makeriga/weatherthing-hardware/README.md

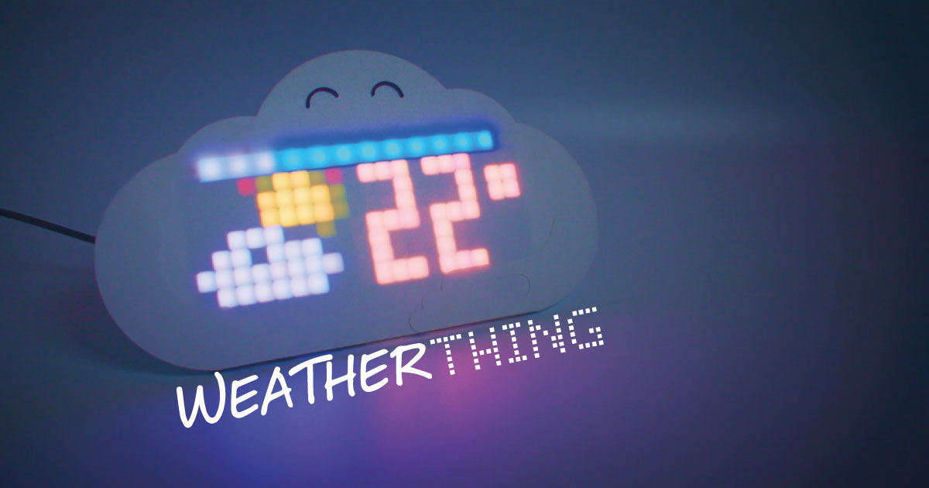
[picture p1: img/weatherthing.jpg]
Weatherthing photo

# weatherthing-hardware
hardware for WeatherThing LED matrix
R0 PCB source files and mech parts + manual pdf
Note: R0 pcb somehow no one paid attention to the 1117 LDO Vin low voltage, thus the battery charging, protection and power path section kinda became redundant. Pls omit or DNP those parts.
