makeriga/weatherthing-hardware/img/box.jpg

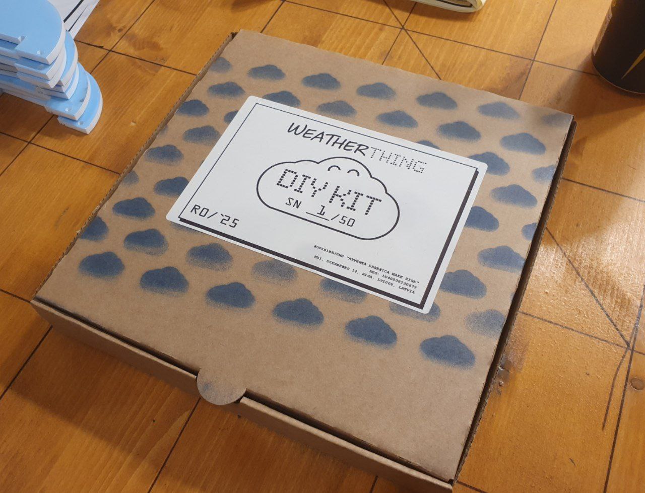
img/box.jpg
