makeriga/weatherthing-hardware/img/contents.jpg

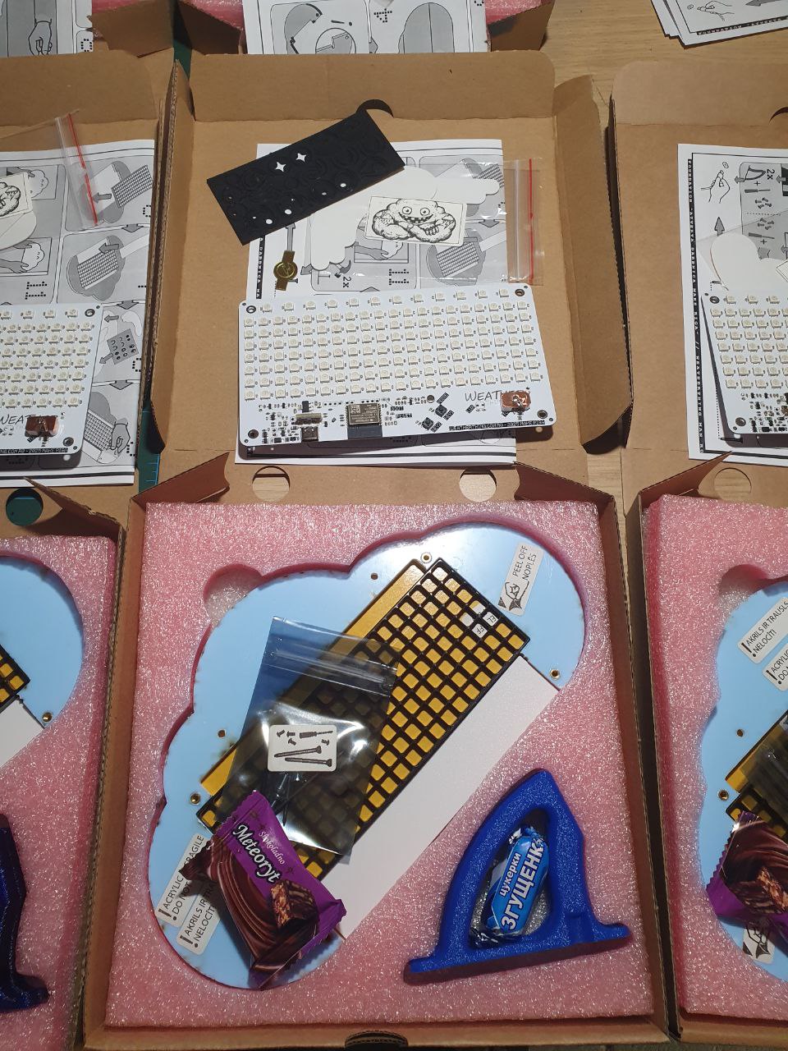
img/contents.jpg
