makeriga/weatherthing-hardware/img/customer1.jpg

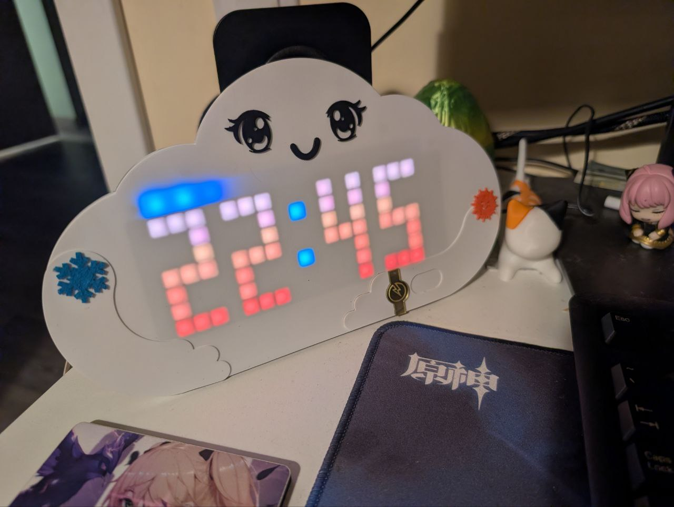
img/customer1.jpg
