makeriga/weatherthing-hardware/img/customer2.jpg

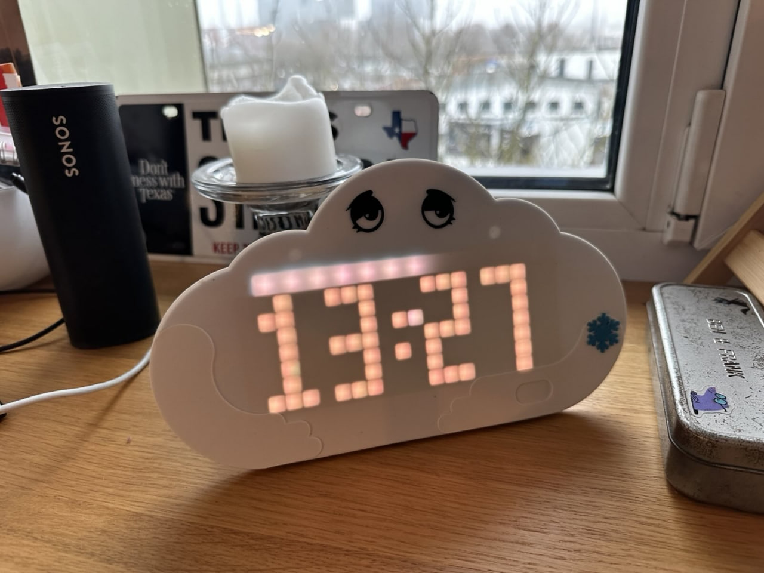
img/customer2.jpg
