makeriga/weatherthing-hardware/img/pcb.jpg

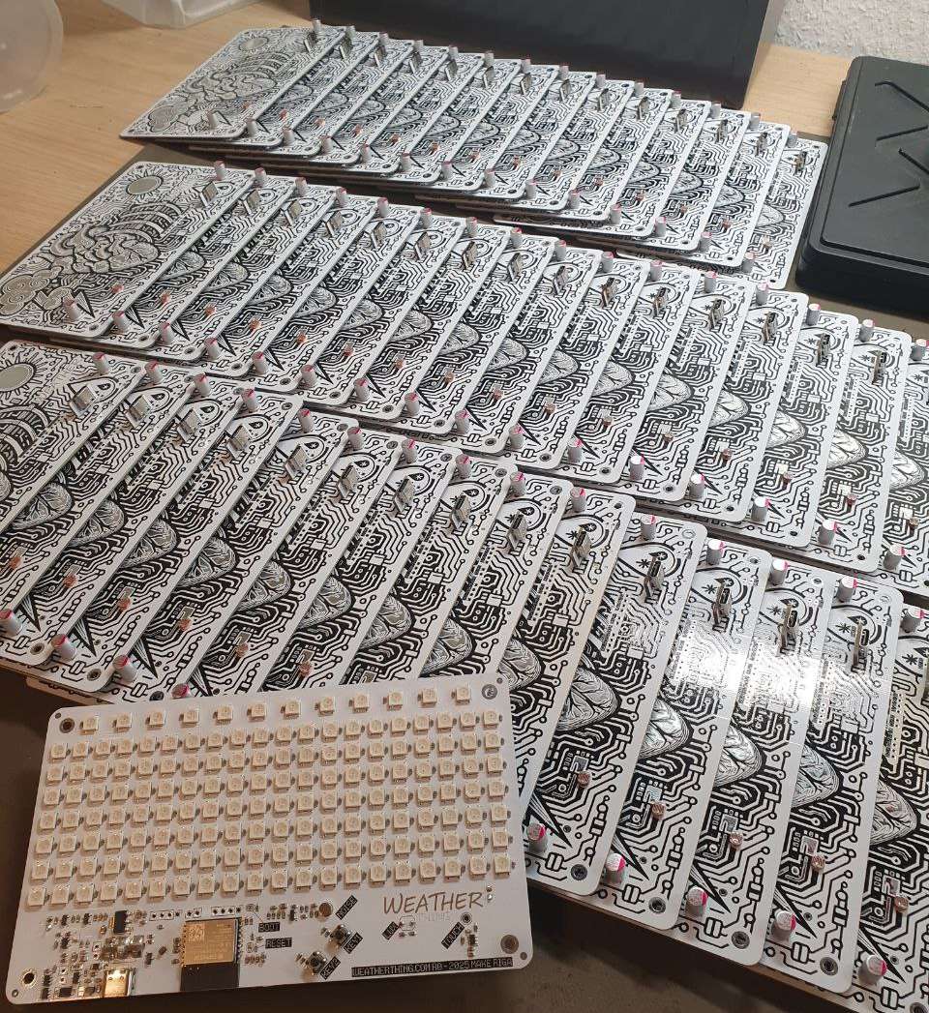
img/pcb.jpg
