makeriga/weatherthing-hardware/mech/support-leg.STEP

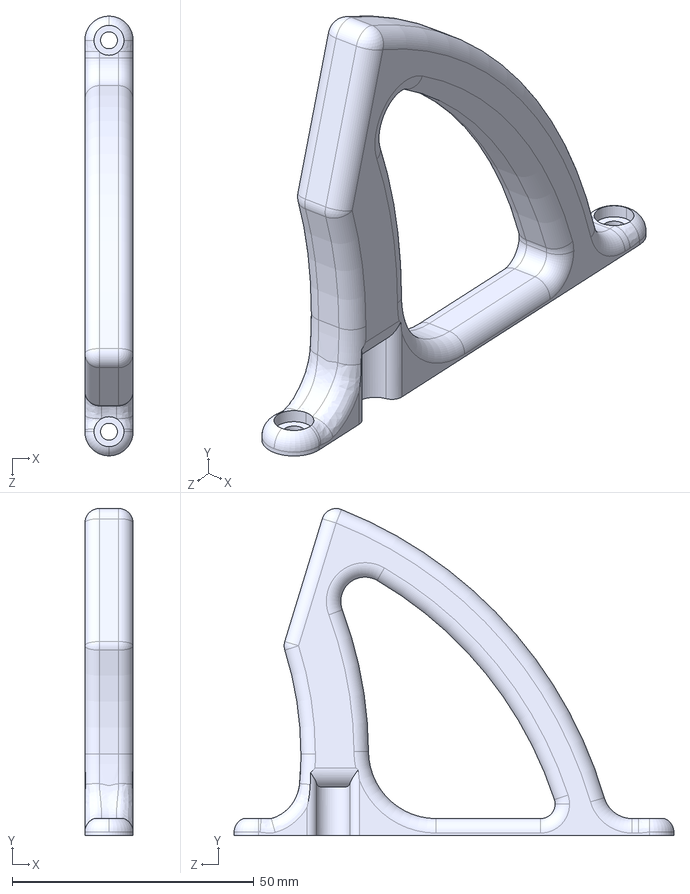
[picture p7: CAD file, 2025-12-18]
mech/support-leg.STEP
10.0 x 67.7 x 91.0 mm
