makeriga/weatherthing-hardware/mech/front-diffuser-0.5mm-PP-doublesided-bottom.DXF

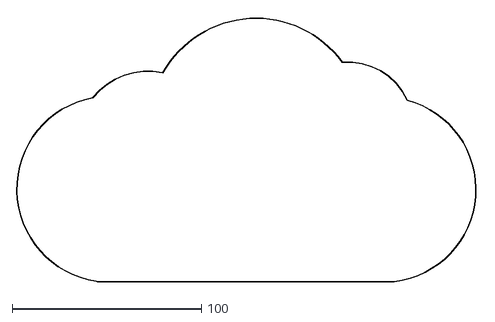
[picture p8: CAD file, 2025-12-18]
mech/front-diffuser-0.5mm-PP-doublesided-bottom.DXF
244.7 x 140.3
