makeriga/weatherthing-hardware/mech/spacer-white-5mm-acrylic.DXF

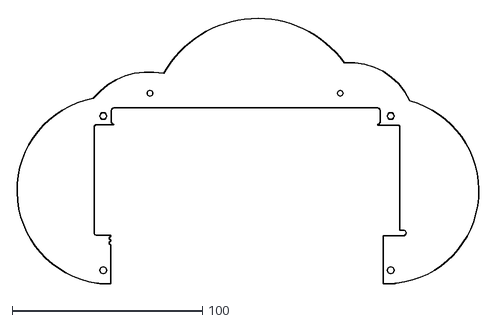
[picture p9: CAD file, 2025-12-18]
mech/spacer-white-5mm-acrylic.DXF
244.7 x 140.3
