makeriga/weatherthing-hardware/mech/crossbleed-stopping-spacer-black-5mm-acrylic.DXF

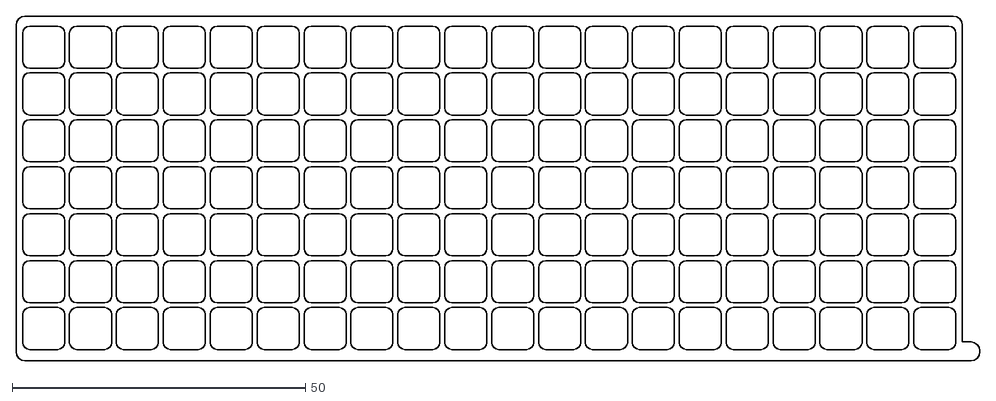
[picture p10: CAD file, 2025-12-18]
mech/crossbleed-stopping-spacer-black-5mm-acrylic.DXF
164.4 x 58.7
