makeriga/weatherthing-hardware/mech/Pizzabox-holder-20mm-PE-ESD-foam.dxf

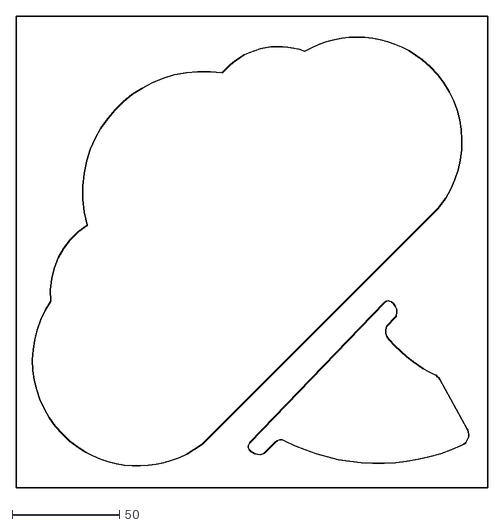
[picture p11: CAD file, 2025-12-18]
mech/Pizzabox-holder-20mm-PE-ESD-foam.dxf
220.0 x 220.0
