makeriga/weatherthing-hardware/mech/front-diffuser-backing-plate-0.5mm-PP-no-adhesive.DXF

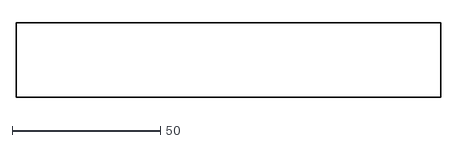
[picture p12: CAD file, 2025-12-18]
mech/front-diffuser-backing-plate-0.5mm-PP-no-adhesive.DXF
143.0 x 25.1
