makeriga/weatherthing-hardware/mech/touch-thingy-5mm.DXF

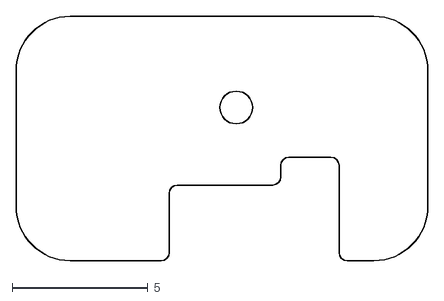
[picture p13: CAD file, 2025-12-18]
mech/touch-thingy-5mm.DXF
15.2 x 9.00
