makeriga/weatherthing-hardware/mech/eyes.dxf

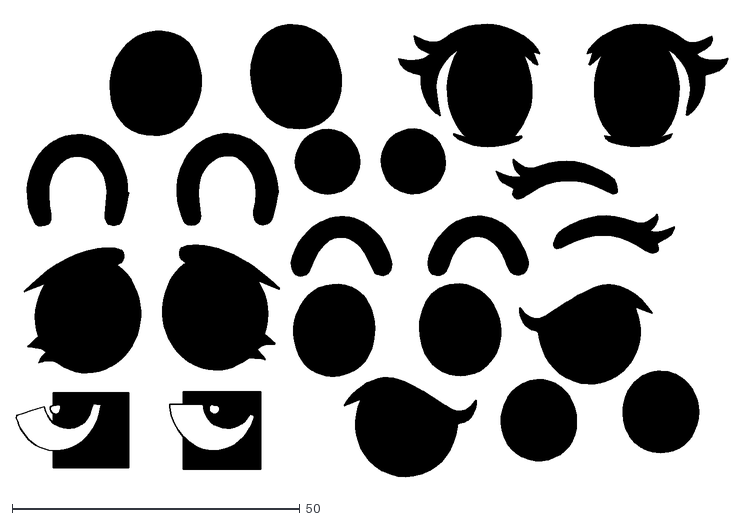
[picture p14: CAD file, 2025-12-18]
mech/eyes.dxf
123.7 x 81.0
