makeriga/weatherthing-hardware/mech/arms-0.5mm-PP-doublesided-bottom.DXF

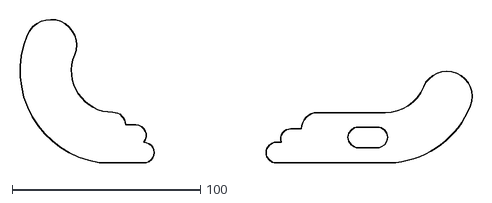
[picture p15: CAD file, 2025-12-18]
mech/arms-0.5mm-PP-doublesided-bottom.DXF
243.9 x 78.0
