makeriga/weatherthing-hardware/(list of files, cad)

Other CAD files:
PCB/R0/weatherthing-usb-pcb/weatherthing-usb-pcb-F_Paste.dxf
