makeriga/weatherthing-hardware/img/assembly.jpg

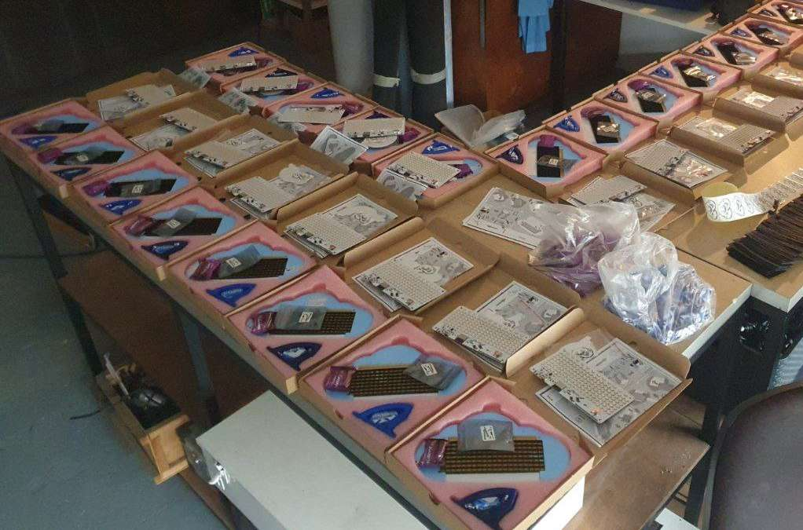
img/assembly.jpg
