makeriga/weatherthing-hardware/img/manual1.jpg

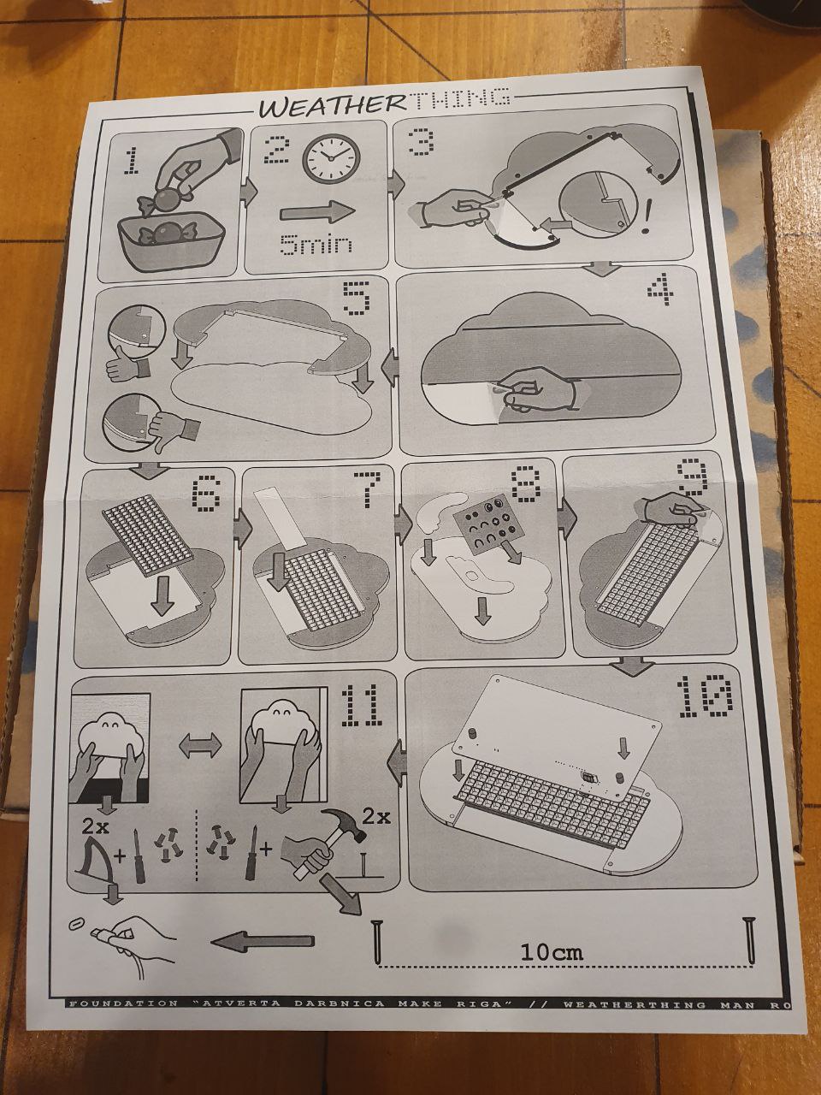
img/manual1.jpg
