makeriga/weatherthing-hardware/img/manual2.jpg

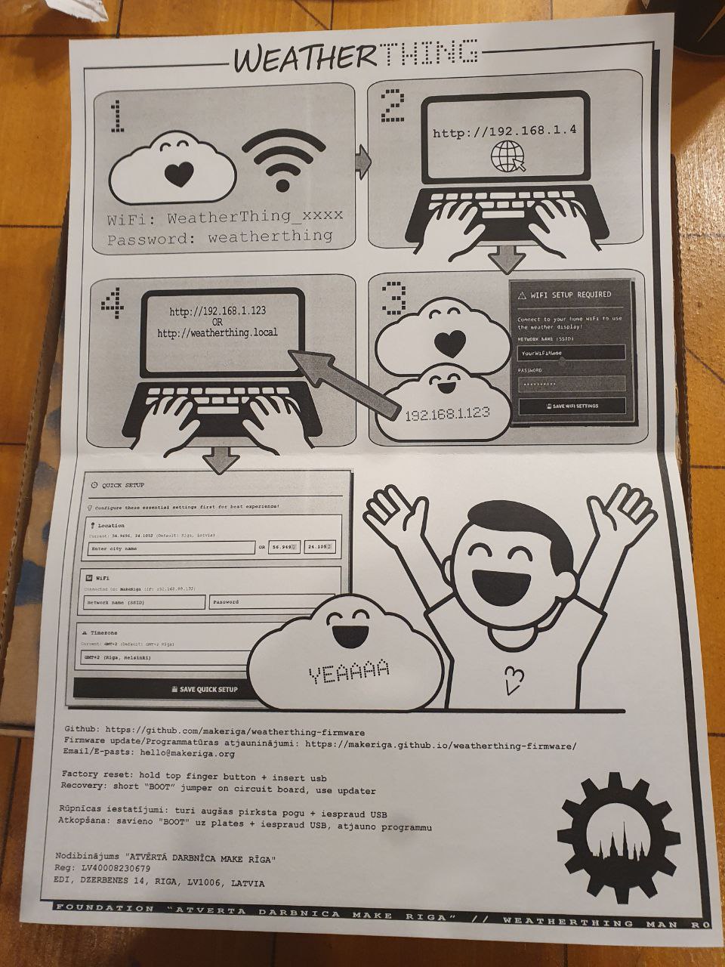
img/manual2.jpg
