makeriga/weatherthing-hardware/PCB/R0/Weatherthing-main-21-30-R0.pdf

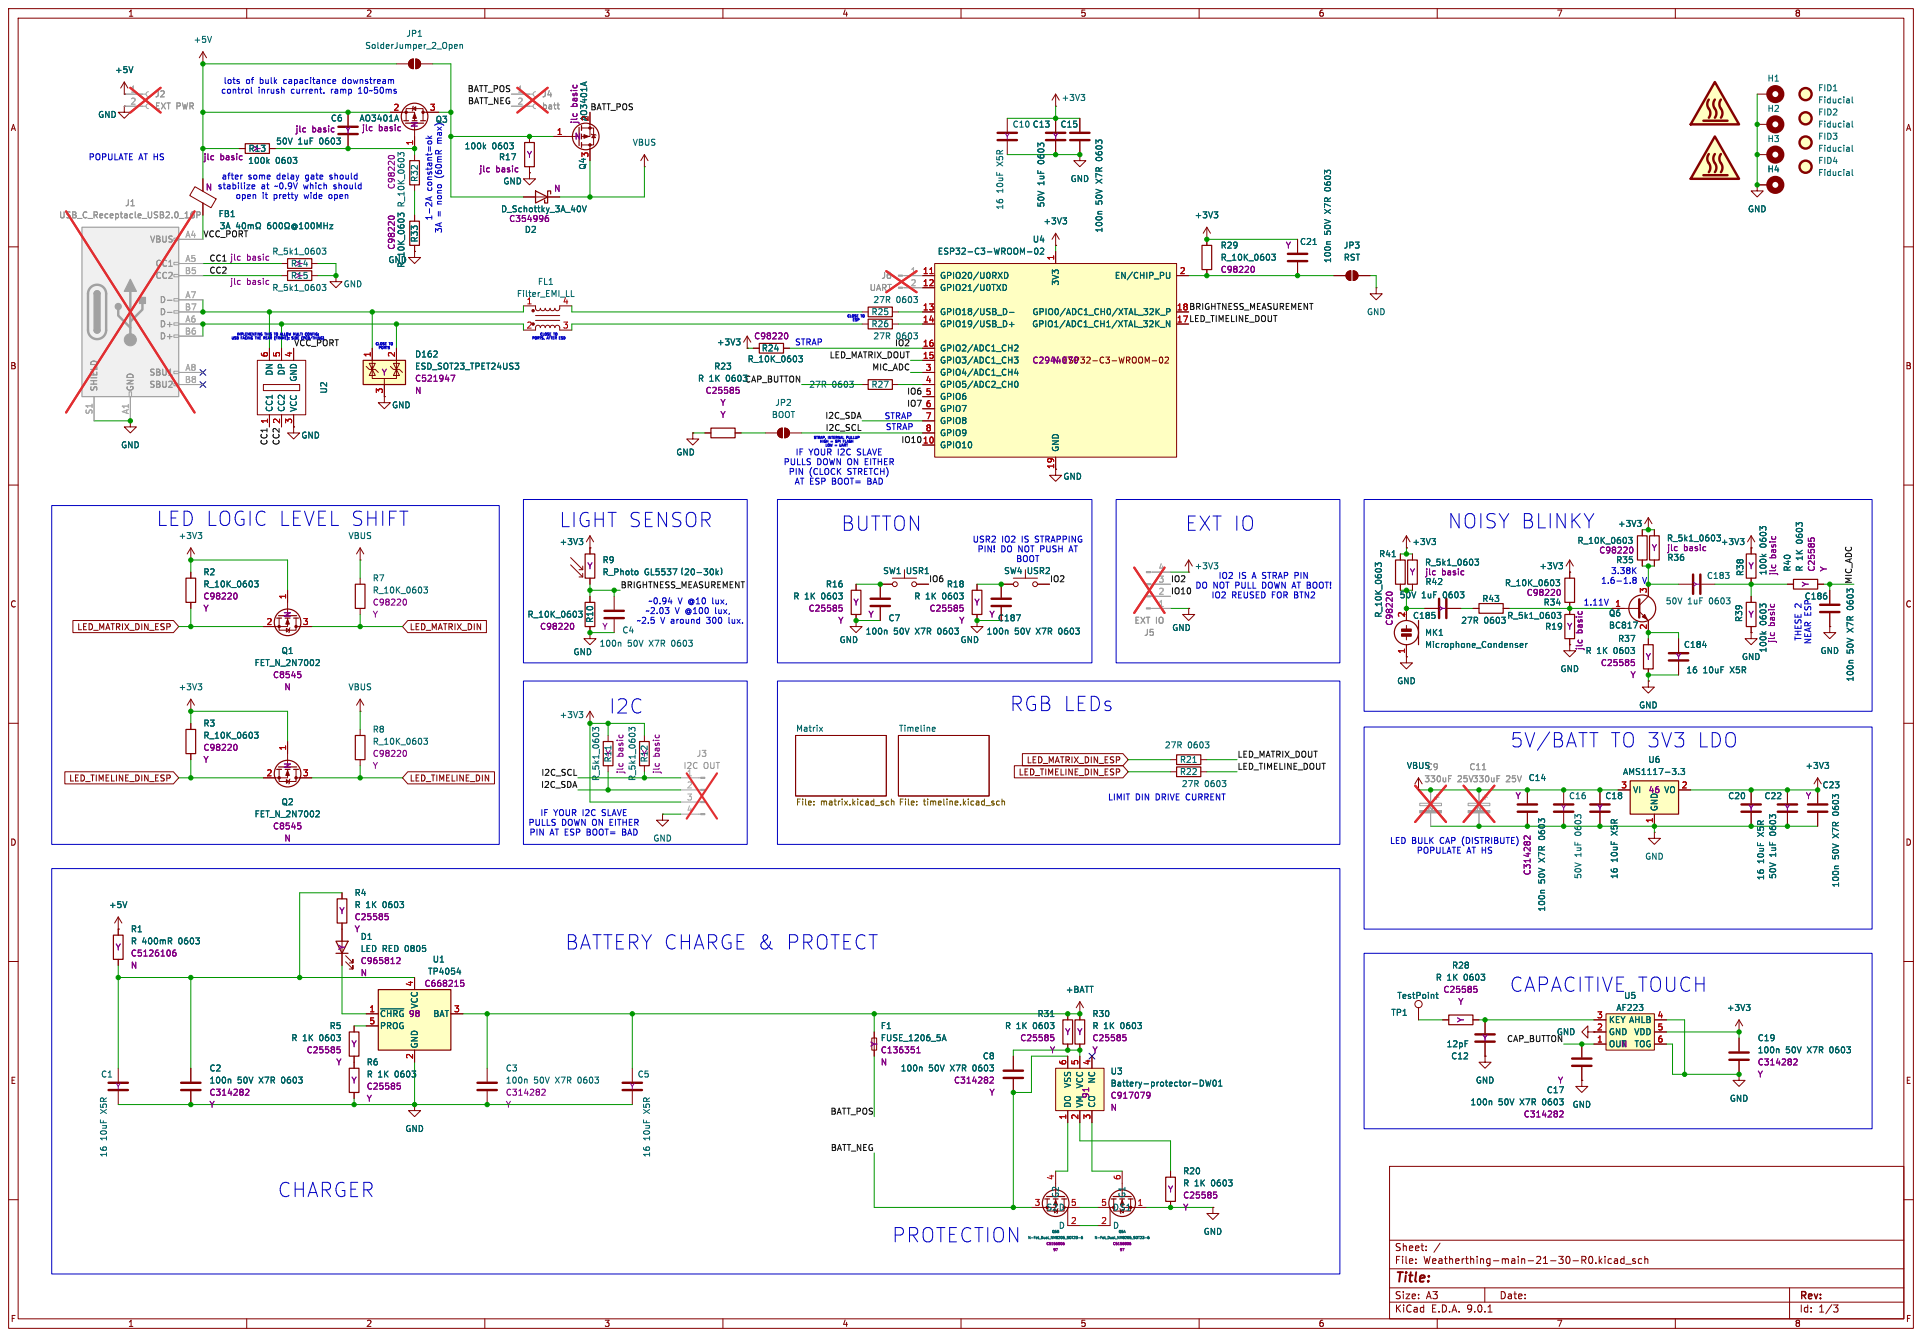
[picture p19: page 1]

jlc basic YD2 D_Schottky_3A_40V C354996 N GND GND

PORTS, AFTER ESD 1-2A constant=ok 3A = nono (60mR max)

after some delay gate should

IMPLEMENTING THIS TO ALLOW MULTI CONFIG: USB FACING THE REAR (FRAME); SIDE (PCB/THING) LED LOGIC LEVEL SHIFT

STRAP, INTERNAL PULLUP HIGH = SPI FLASH
IF YOUR I2C SLAVE
PULLS DOWN ON EITHER
PIN (CLOCK STRETCH) AT ESP BOOT= BAD

PIN! DO NOT PUSH AT BOOT

IO2 IS A STRAP PIN
DO NOT PULL DOWN AT BOOT!

PIN AT ESP BOOT= BAD

LED BULK CAP (DISTRIBUTE) POPULATE AT HS

Y OUT 1 GND 2 KEY 3 TOG

Id: 1/3 Title: File: Weatherthing-main-21-30-R0.kicad_sch Sheet: /

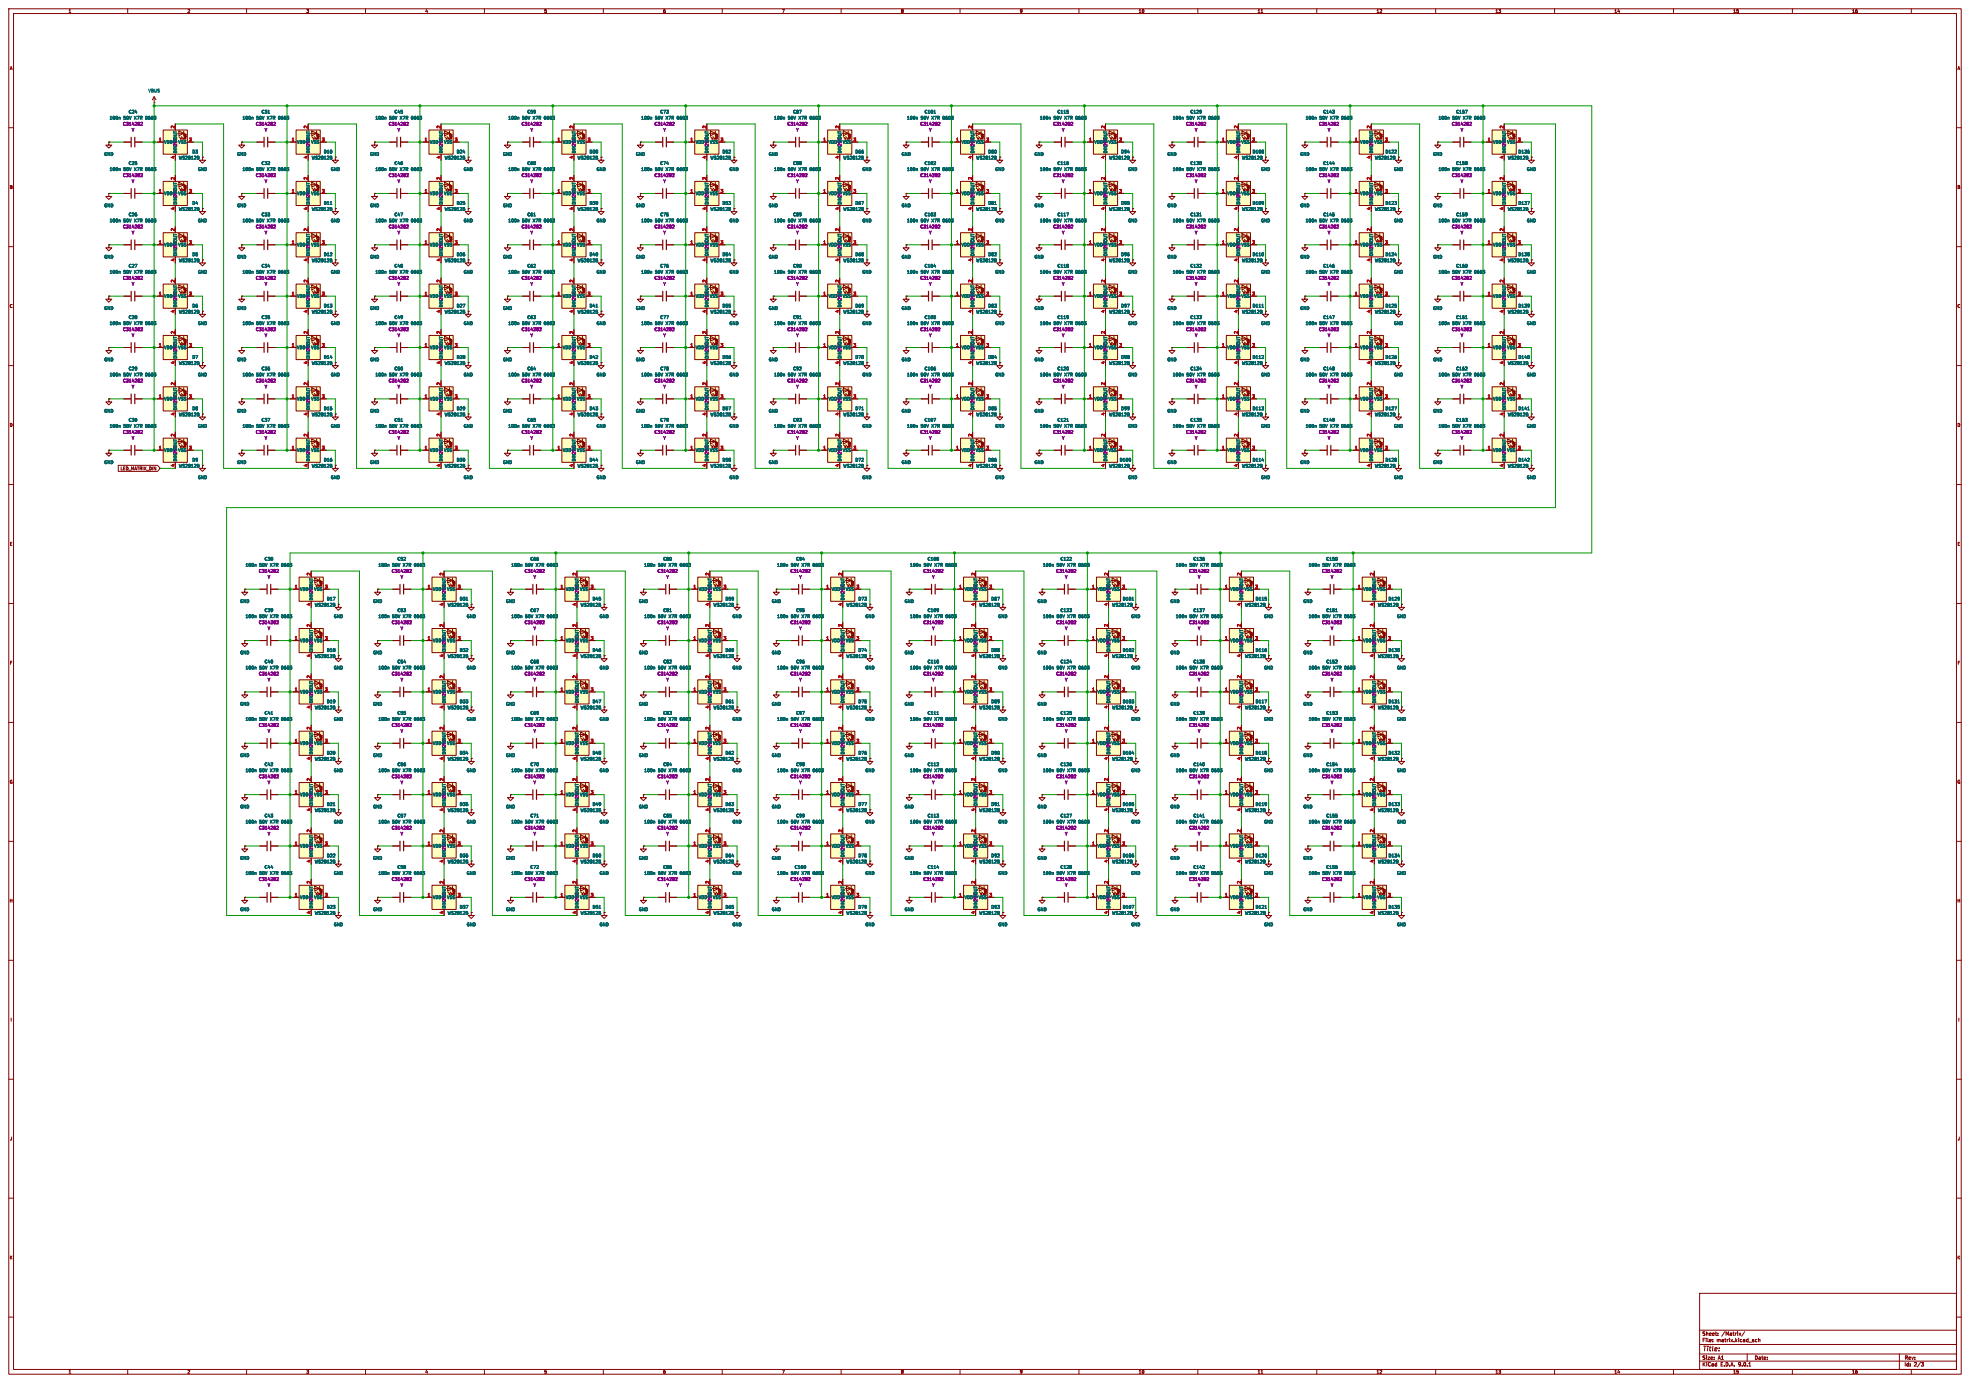
[picture p20: page 2]

2 D67 WS2812B 297 GND GND RGB DIN

2 D93 WS2812B 297 GND GND RGB DIN

2 D5 WS2812B 297 GND GND GND GND GND RGB DIN

2 GND GND GND GND GND

2 GND GND GND D54 WS2812B 297 DIN

Id: 2/3 Title: File: matrix.kicad_sch Sheet: /Matrix/ RGB DIN

2 D13 WS2812B 297 GND GND GND GND GND

100n 50V X7R 0603 C314282 Y GND GND RGB DIN

100n 50V X7R 0603 C314282 Y GND GND GND GND GND

2 D139 WS2812B 297 GND GND RGB DIN

2 D142 WS2812B 297 GND GND RGB DIN

2 D8 WS2812B 297 GND GND RGB DIN

2 D102 WS2812B 297 GND GND GND GND GND

2 D100 WS2812B 297 GND GND RGB DIN
GND RGB DIN

4 VDD 1 VSS DOUT 3

2 D77 WS2812B 297 GND GND RGB DIN

100n 50V X7R 0603 C314282 Y GND GND GND RGB DIN

D34 WS2812B 297 DIN

2 D79 WS2812B 297 GND GND RGB DIN

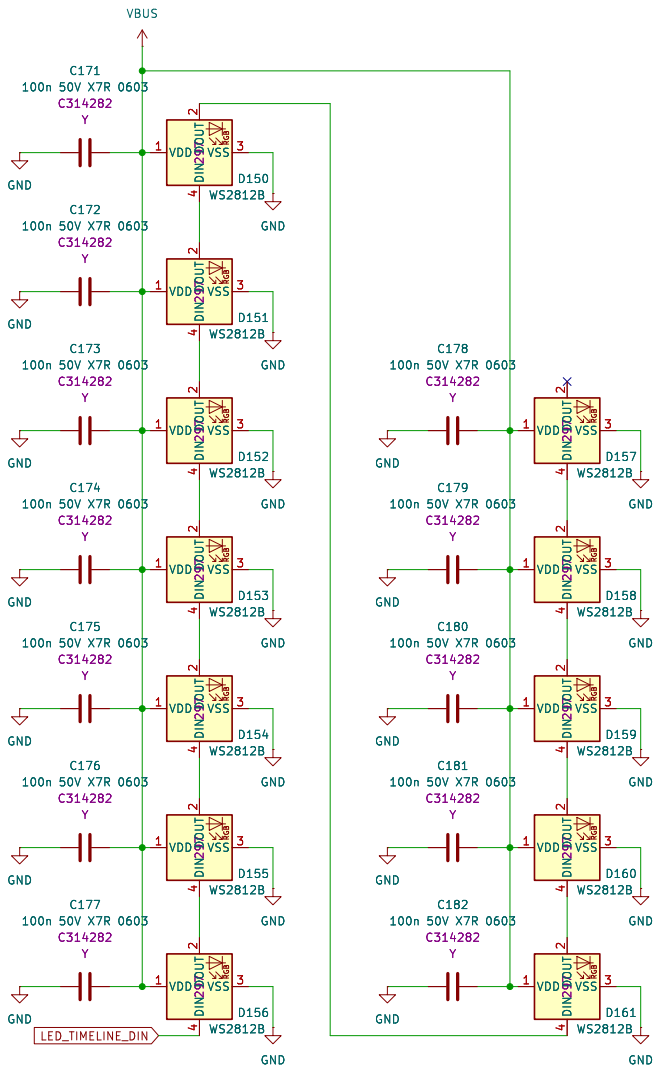
[picture p21: page 3]

Id: 3/3 Title: File: timeline.kicad_sch Sheet: /Timeline/
