makeriga/weatherthing-hardware/manual/user-manual-assembly-a4.pdf

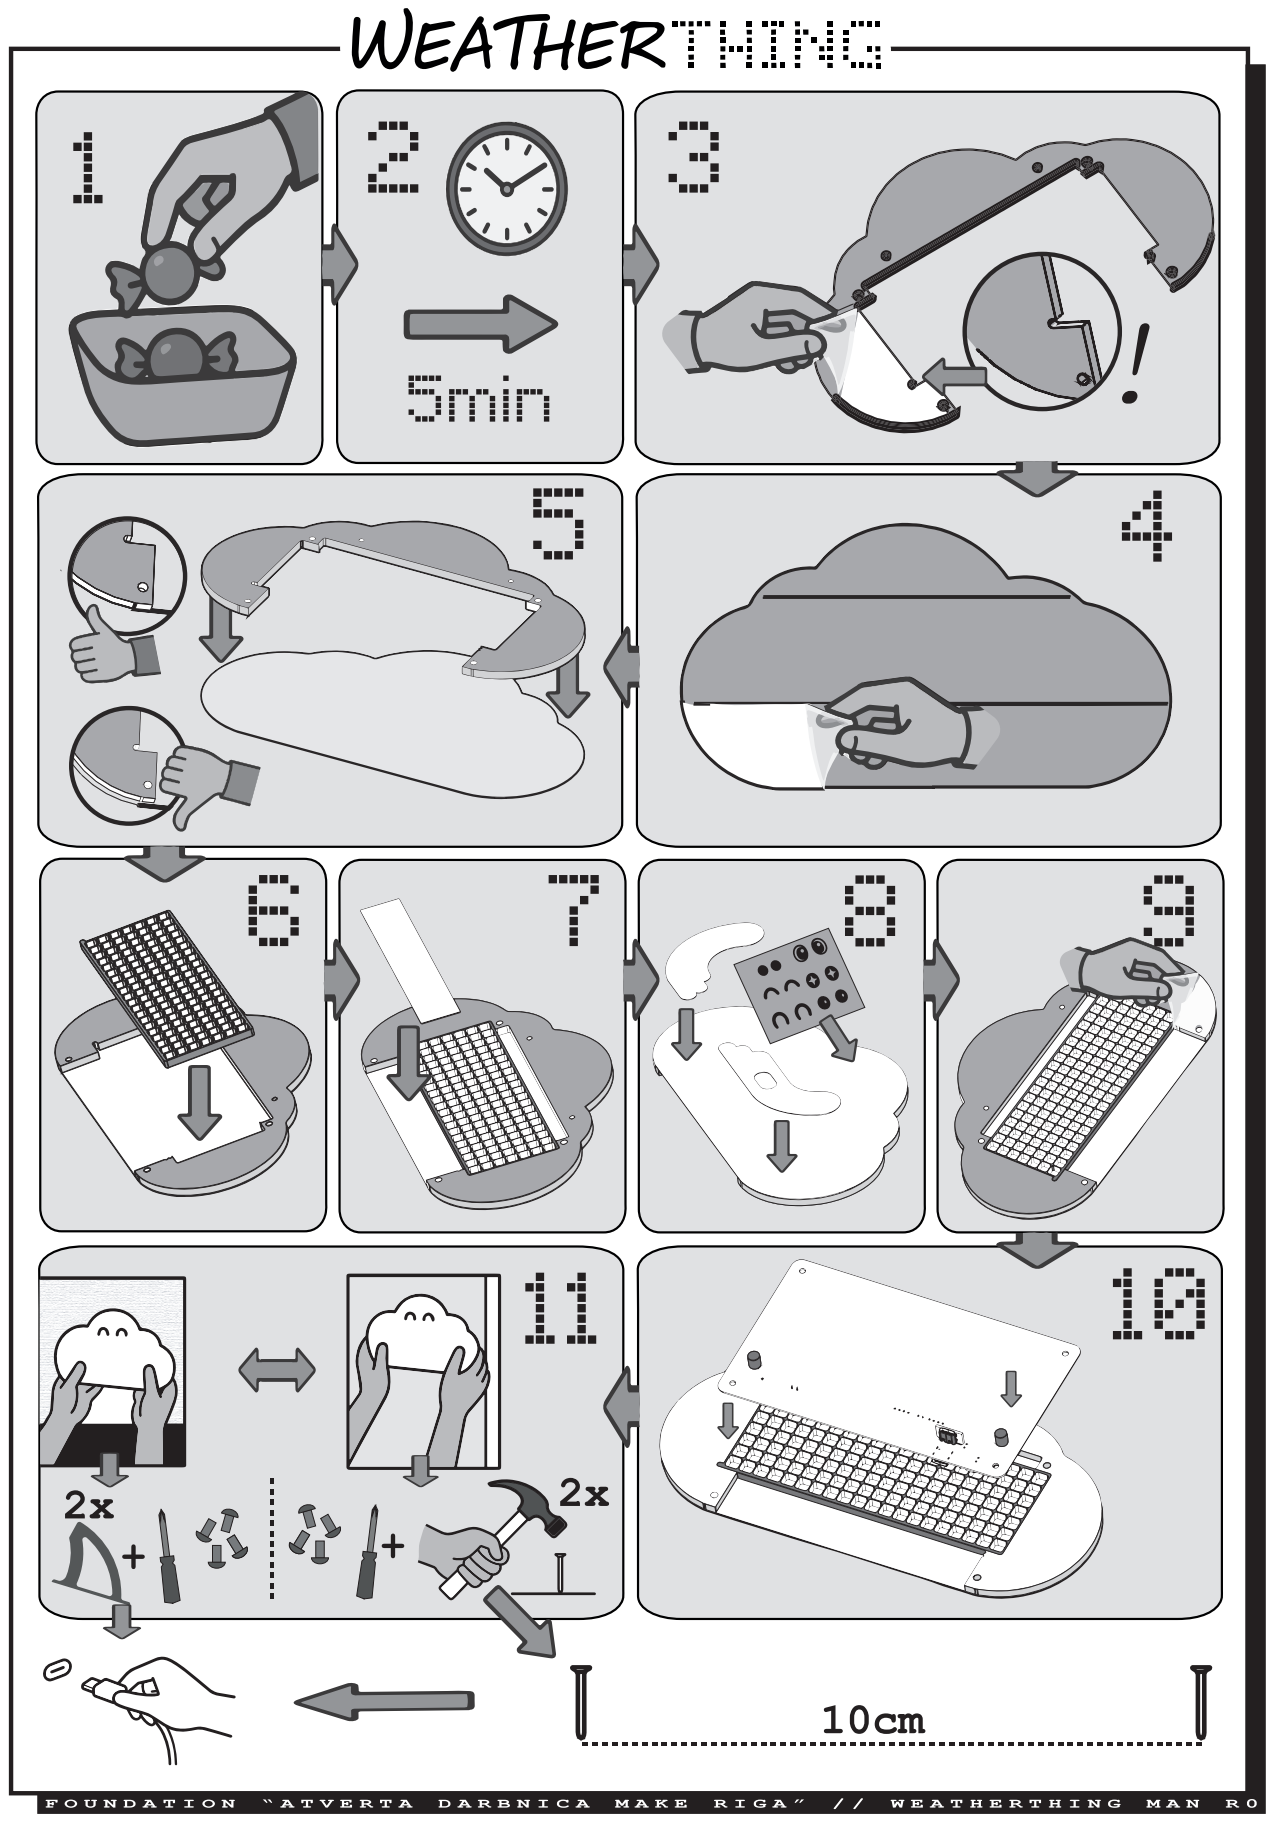
[picture p22: page 1]
