makeriga/weatherthing-hardware/manual/user-manual-setup-a4.pdf

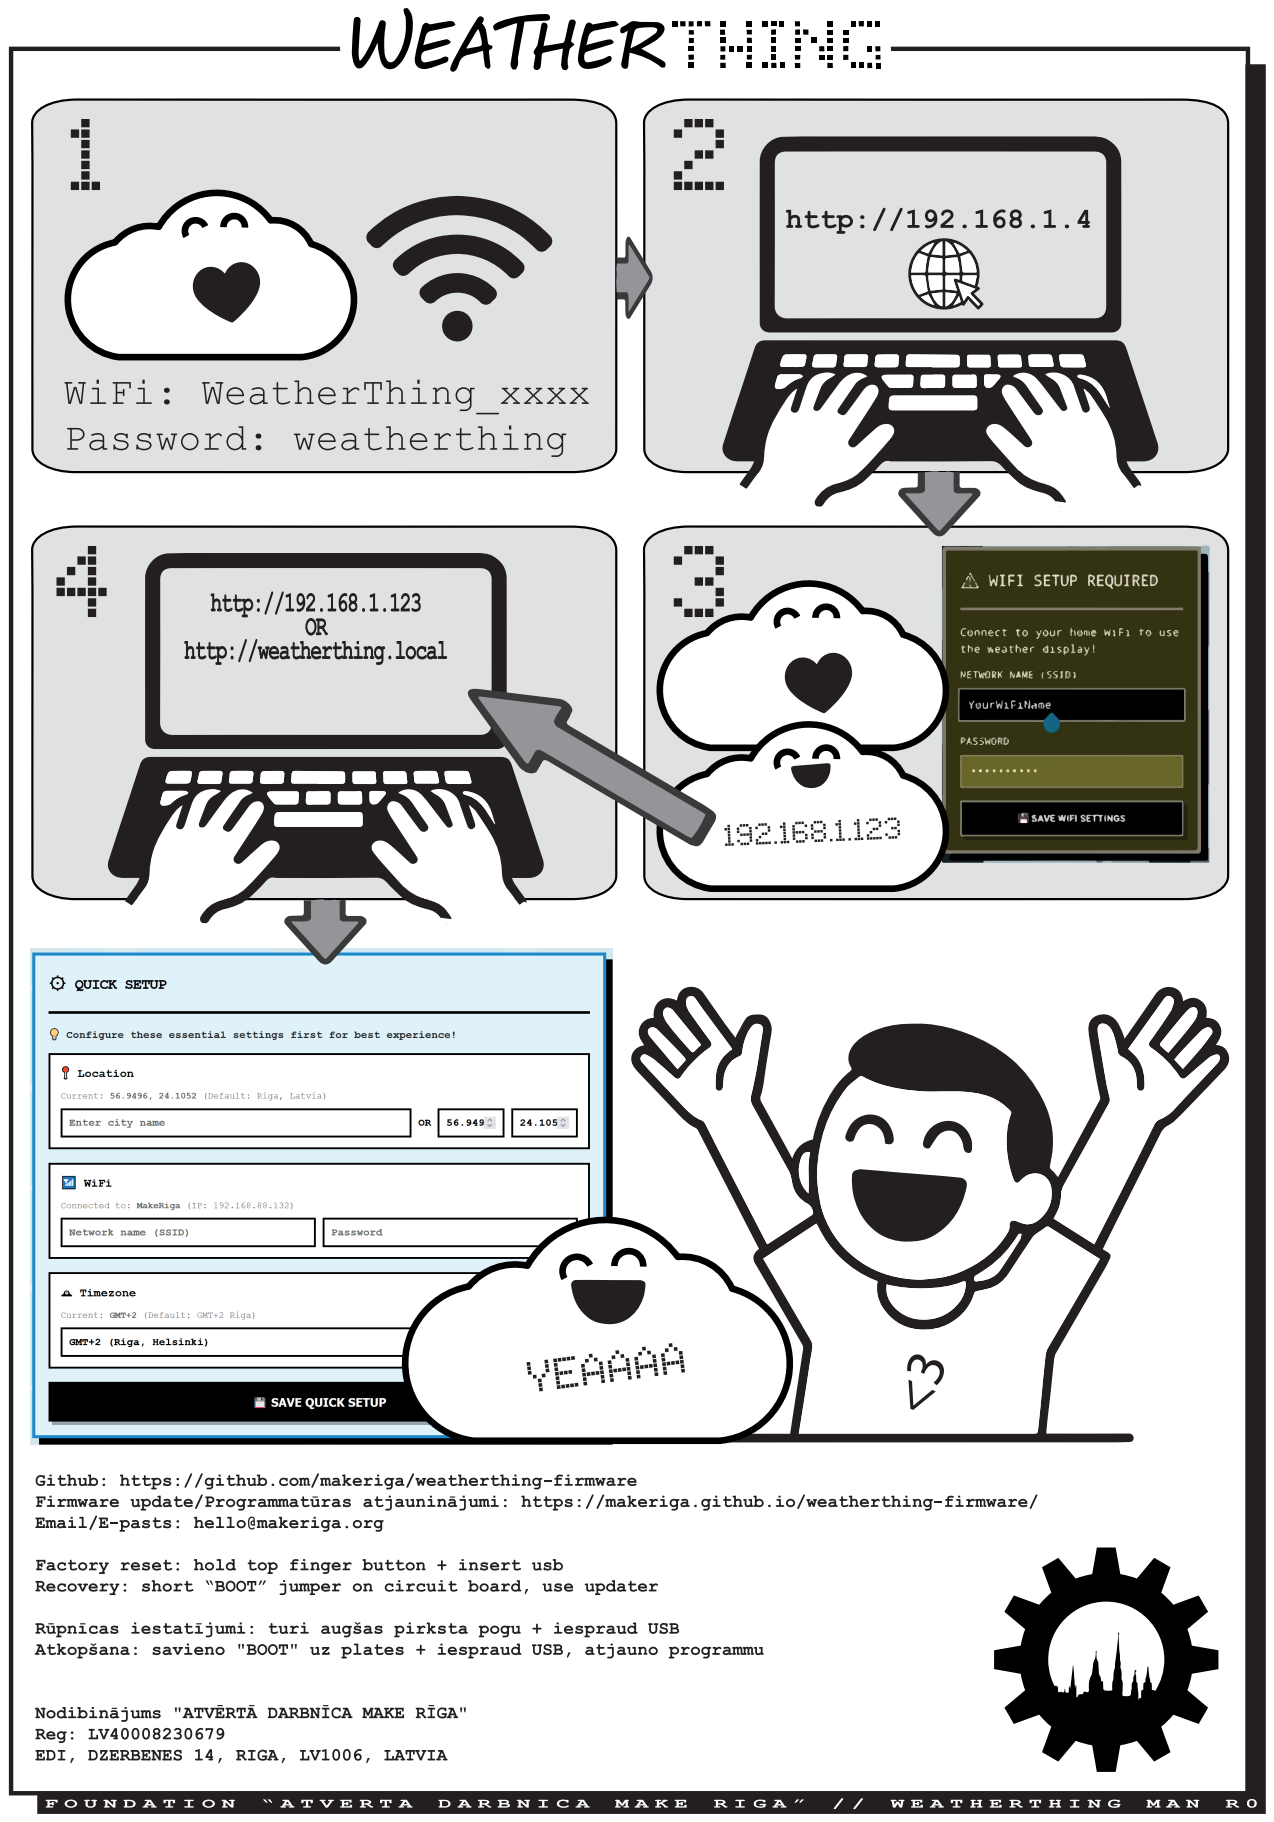
[picture p23: page 1]
