makeriga/weatherthing-hardware/PCB/R0/weatherthing-usb-pcb/weatherthing-usb-pcb.kicad_pcb

## KiCad design PCB/R0/weatherthing-usb-pcb/weatherthing-usb-pcb.kicad_pcb (2025-12-18)

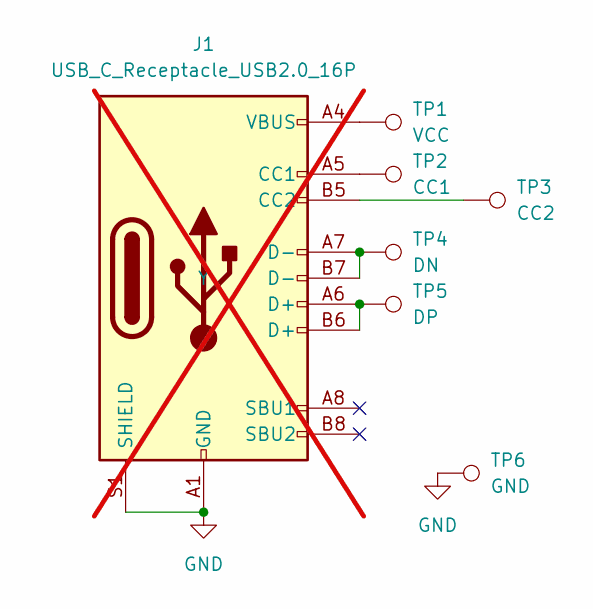
[picture p24: schematic weatherthing-usb-pcb.kicad_sch]

Parts:
J1: USB_C_Receptacle_USB2.0_16P; USB_C_Receptacle_GCT_USB4105-xx-A_16P_TopMnt_Horizontal; not fitted
TP1: VCC; pad-28-35
TP2: CC1; pad-28-35
TP3: CC2; pad-28-35
TP4: DN; pad-28-35
TP5: DP; pad-28-35
TP6: GND; pad-28-35

Connections:
GND: J1.A1 (GND), J1.A12 (GND), J1.B1 (GND), J1.B12 (GND), J1.S1 (SHIELD), TP6.1
unnamed: J1.A5 (CC1), TP2.1
unnamed: J1.B5 (CC2), TP3.1
unnamed: J1.A6 (D+), J1.B6 (D+), TP5.1
unnamed: J1.A7 (D-), J1.B7 (D-), TP4.1
unnamed: J1.A4 (VBUS), J1.A9 (VBUS), J1.B4 (VBUS), J1.B9 (VBUS), TP1.1

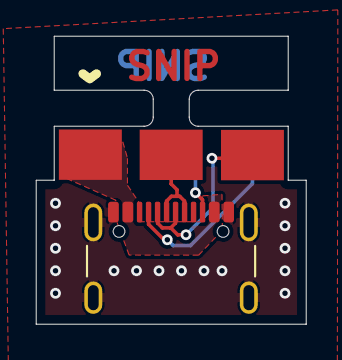
[picture p25: board weatherthing-usb-pcb.kicad_pcb from above]

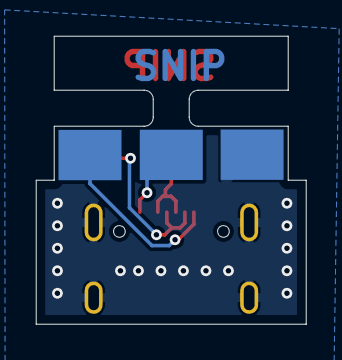
[picture p26: board weatherthing-usb-pcb.kicad_pcb from below]

Board: 2 copper layers, 15.0 x 16.0 mm, 7 parts (3 on the bottom side), 6 nets.
